adafruit/Adafruit-RV-8803-High-Accuracy-Real-Time-Clock-PCB/Adafruit RV-8803 RTC Breakout Board.brd

## EAGLE design Adafruit RV-8803 RTC Breakout Board.brd (2026-10-26)

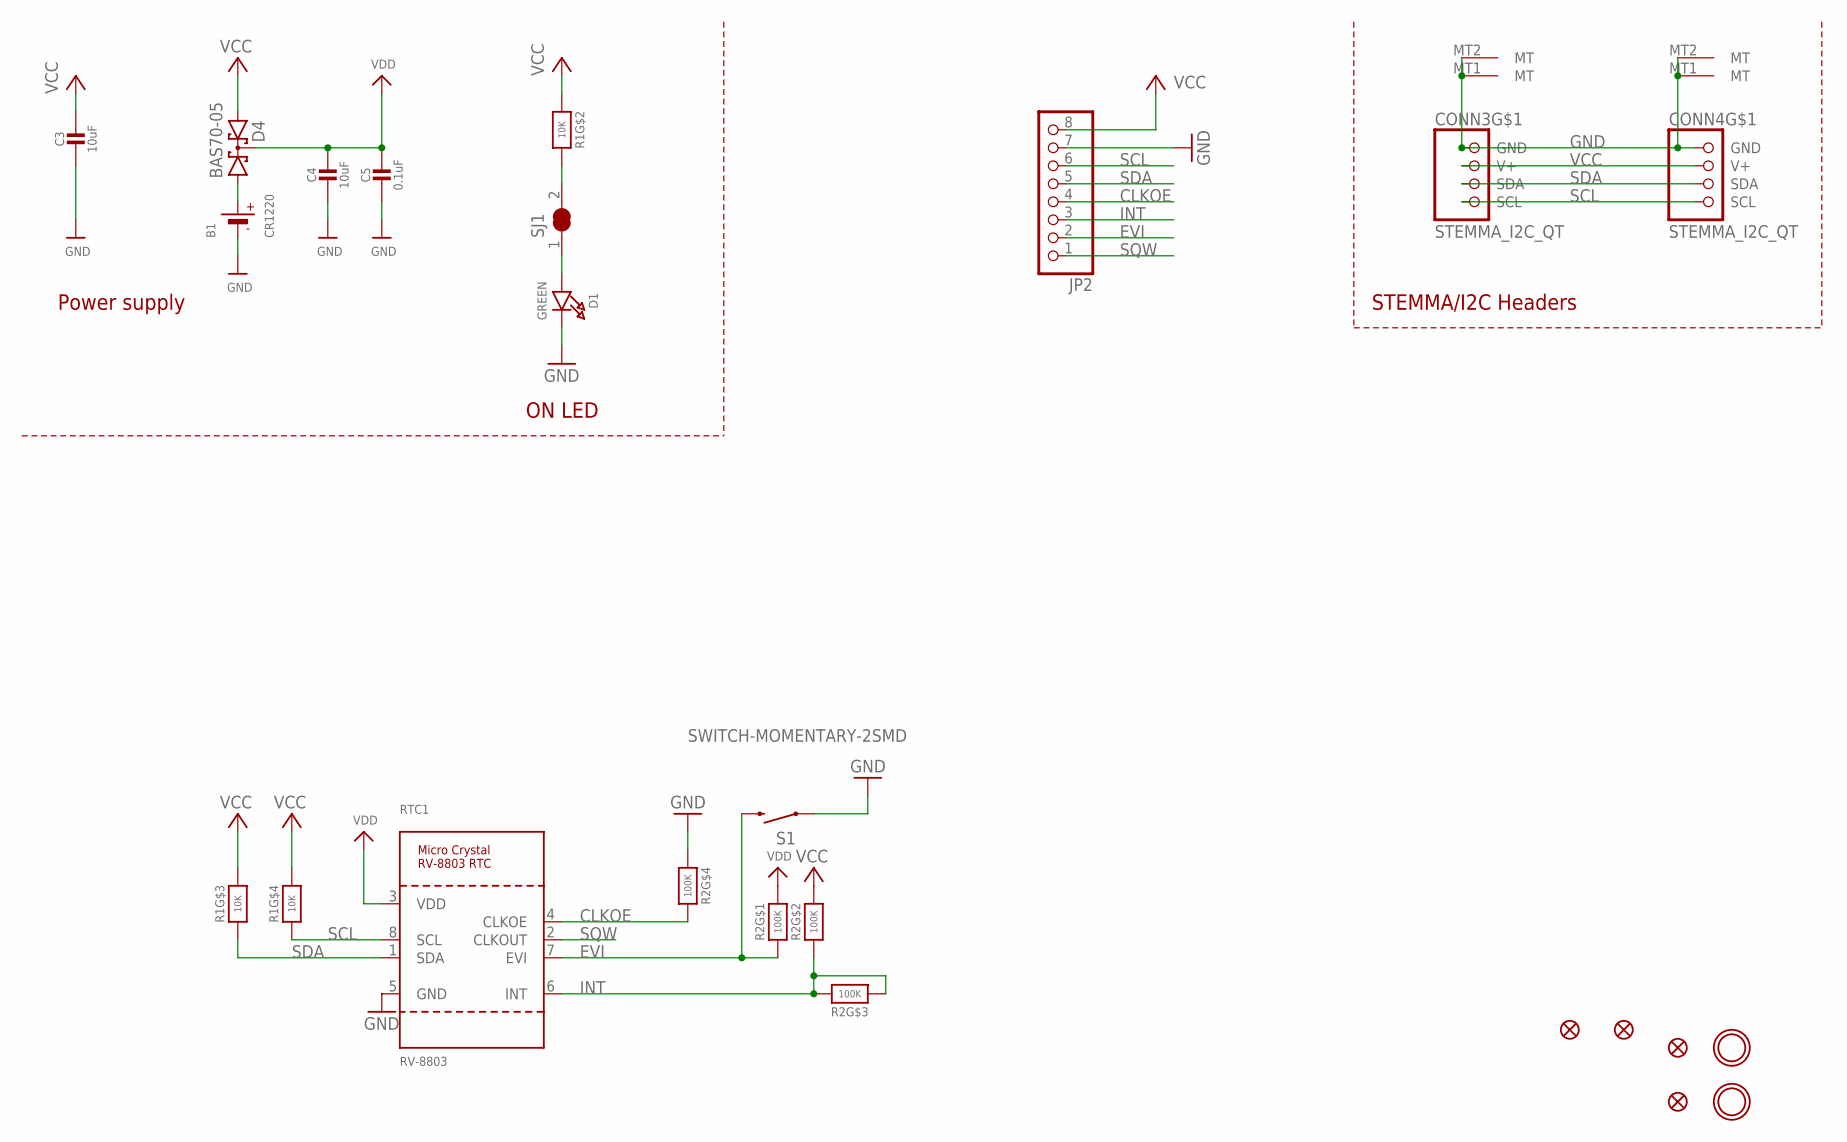
[picture p2: schematic Adafruit RV-8803 RTC Breakout Board.sch]

Parts:
B1: CR1220
C3, C4: 10uF; 0805-NO
C5: 0.1uF; 0603-NO
CONN3, CONN4: STEMMA_I2C_QT; JST_SH4
D1: GREEN; CHIPLED_0603_NOOUTLINE
D4: BAS70-05; SOT23
FID1, FID2, FID3, FID4: FIDUCIAL_0.5MM
JP2: HEADER-1X870MIL; 1X08_ROUND_70
R1: 10K; RESPACK_4X0603
R2: 100K; RESPACK_4X0603
RTC1: RV-8803; DFN8_RVRTC
S1: SWITCH-MOMENTARY-2SMD; TACTILE_SWITCH_SMD
SJ1: SOLDERJUMPER_CLOSED; SOLDERJUMPER_CLOSEDWIRE
U$9, U$17: MOUNTINGHOLE2.5; MOUNTINGHOLE_2.5_PLATED

Connections:
CLKOE: JP2.4, R2.5 (2), RTC1.4 (CLKOE)
EVI: JP2.2, R2.1, RTC1.7 (EVI), S1.3 (2)
GND: B1.-, C3.2, C4.2, C5.2, CONN3.1 (GND), CONN3.MT1 (MT), CONN3.MT2 (MT), CONN4.1 (GND), CONN4.MT1 (MT), CONN4.MT2 (MT), D1.C, JP2.7, R2.4 (1), RTC1.5 (GND), S1.1
INT: JP2.3, R2.2 (1), R2.3 (1), R2.6 (2), RTC1.6 (INT)
unnamed: R1.7 (2), SJ1.2
unnamed: B1.+$1 (+), B1.+$2 (+), D4.1 (A1)
unnamed: D1.A, SJ1.1
SCL: CONN3.4 (SCL), CONN4.4 (SCL), JP2.6, R1.4 (1), RTC1.8 (SCL)
SDA: CONN3.3 (SDA), CONN4.3 (SDA), JP2.5, R1.3 (1), RTC1.1 (SDA)
SQW: JP2.1, RTC1.2 (CLKOUT)
VCC: C3.1, CONN3.2 (V+), CONN4.2 (V+), D4.2 (A2), JP2.8, R1.2 (1), R1.5 (2), R1.6 (2), R2.7 (2)
VDD: C4.1, C5.1, D4.3 (CC), R2.8 (2), RTC1.3 (VDD)

Notes on the sheet:
STEMMA/I2C Headers
ON LED
Power supply

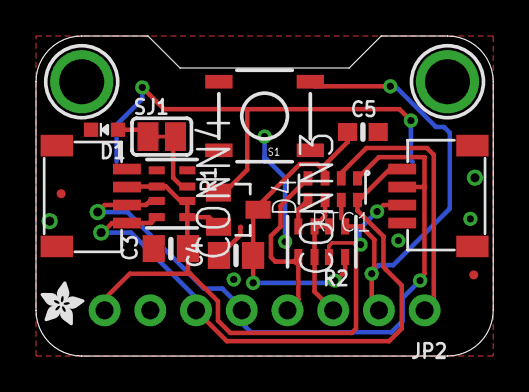
[picture p3: board Adafruit RV-8803 RTC Breakout Board.brd from above]

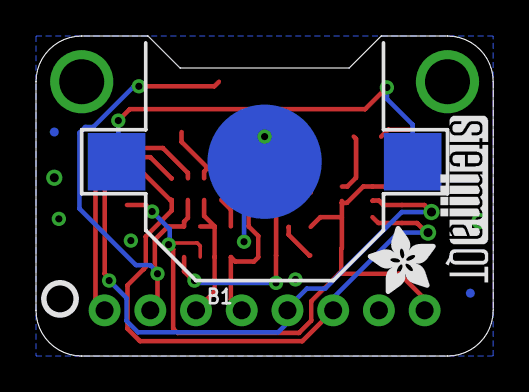
[picture p4: board Adafruit RV-8803 RTC Breakout Board.brd from below]

Board: 2 copper layers, 25.4 x 17.8 mm, 38 parts (8 on the bottom side), 12 nets.

Other parts of the board:
E$1: ADAFRUIT_2.5MM
PLABEL0: PLABEL0
PLABEL1: PLABEL1
PLABEL2: PLABEL2
PLABEL3: PLABEL3
PLABEL4: PLABEL4
PLABEL5: PLABEL5
PLABEL6: PLABEL6
PLABEL7: PLABEL7
PLABEL8: PLABEL8
PLABEL9: PLABEL9
PLABEL10: PLABEL10
PLABEL11: PLABEL11
PLABEL12: PLABEL12
PLABEL13: PLABEL13
U$22: ADAFRUIT_3.5MM
U$25: PCBFEAT-REV-040
U$31: STEMMAQT
